sukcesoia/lightSource/eagle/lightSource.pdf

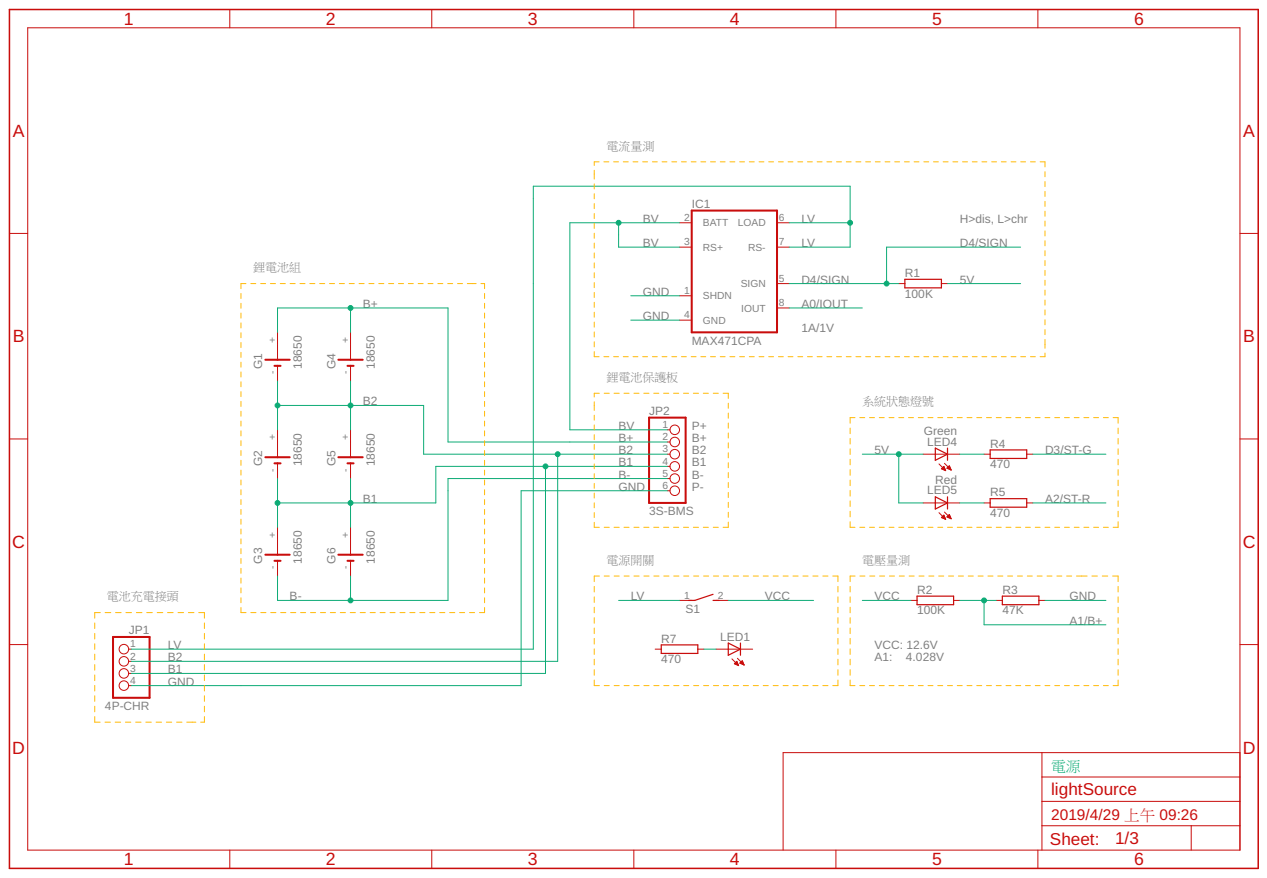
[picture p1: page 1]

18650 18650 18650 4P-CHR 3S-BMSMAX471CPA 100K100K 47K 470 18650 18650 18650 Green Red 470 470 P+B+B2B1B- P- VCC: 12.6V A1: 4.028V 電壓量測 鋰電池保護板 H>dis, L>chr 1A/1V 電流量測 鋰電池組 電源開關 電池充電接頭 系統狀態燈號 G1 + - G2 + - G3 + - JP1 1234 JP2123456 IC1BATT 2 RS+ 3 SHDN 1 GND 4 LOAD 6 SIGN 5 RS- 7 IOUT 8 S1 1 2 R1R2 R3 R7 LED1 G4 + - G5 + - G6 + - LED4 LED5 R4 R5 B2 B2 B2 B1 B1 B1 B- B- B+ B+ LV LVLV LV GND GND GND GND GND BV BVBV VCC VCC D4/SIGN D4/SIGN A0/IOUT 5V 5V A1/B+ A2/ST-R D3/ST-G lightSource 2019/4/29 上午 09:26 Sheet: 1/3 ABCD 1 2 3 4 5 6 ABCD 1 2 3 4 5 6 電源

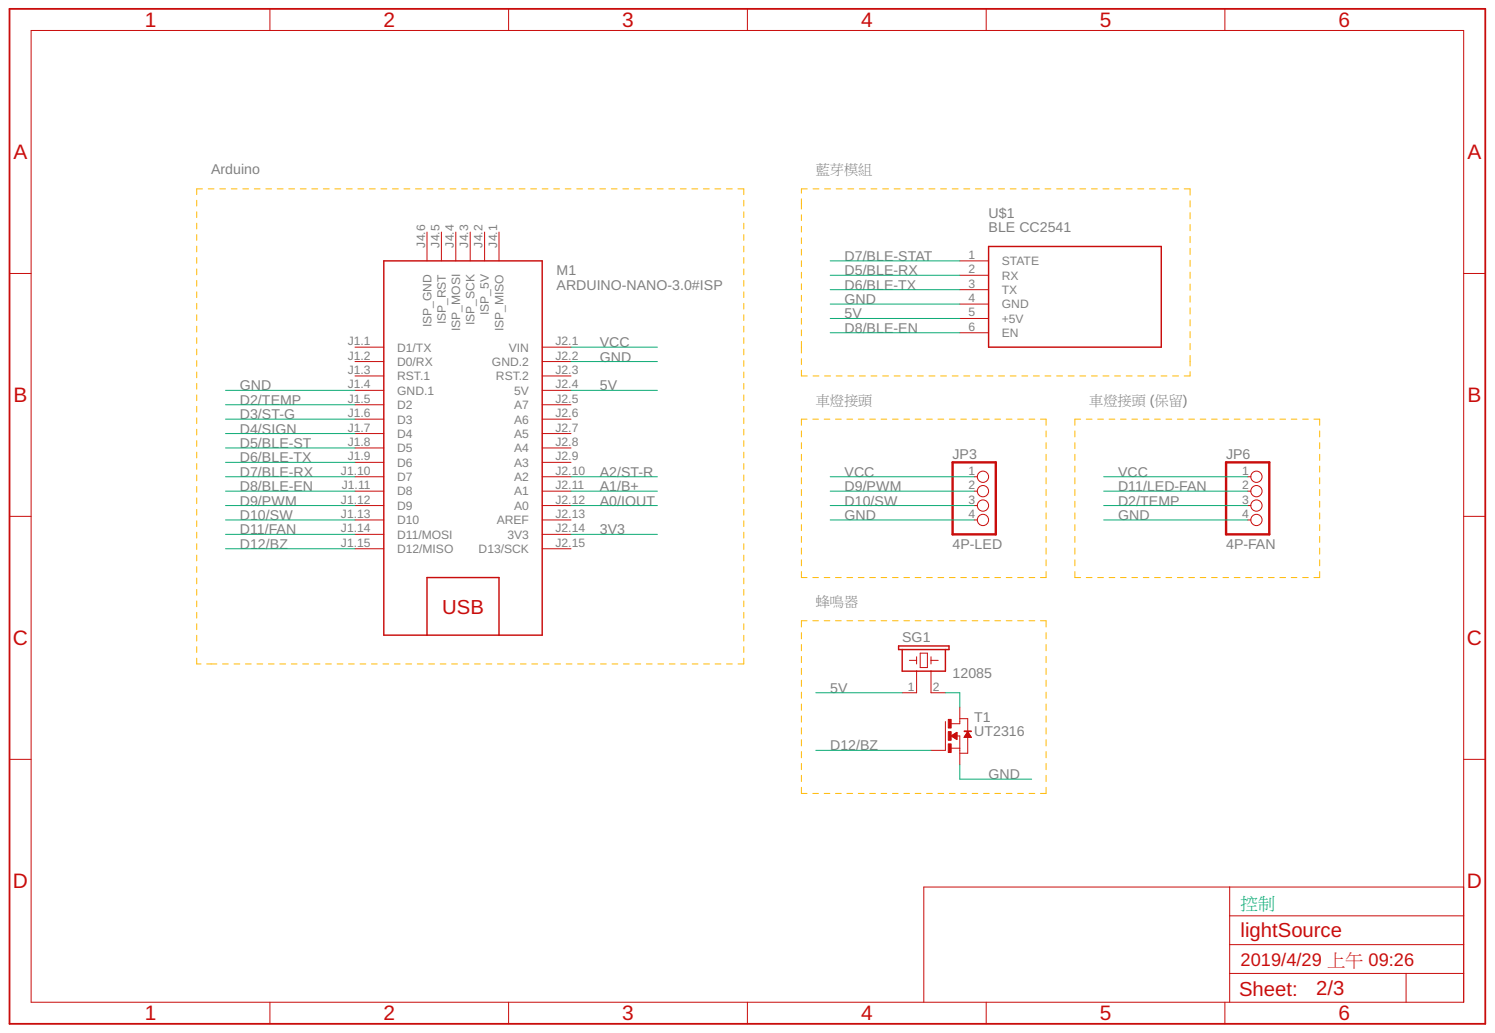
[picture p2: page 2]

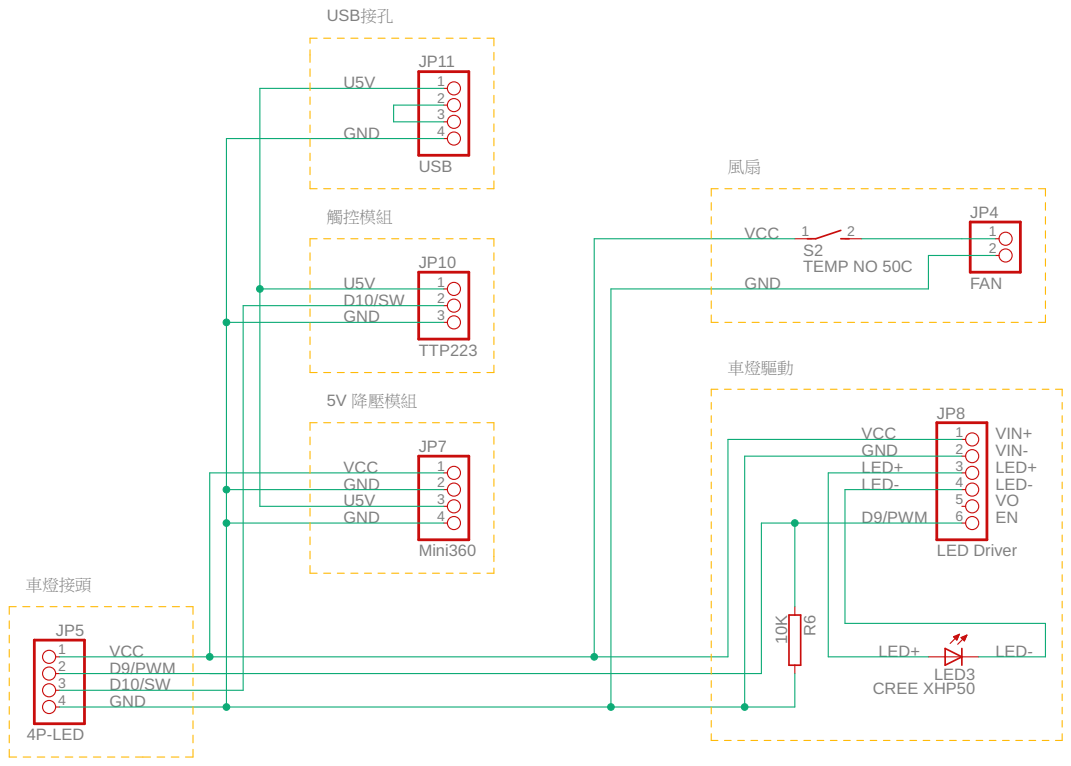
[picture p3: page 3]
