sukcesoia/lightSource/eagle/lightSource.sch

## EAGLE design eagle/lightSource.sch (2019-04-29)

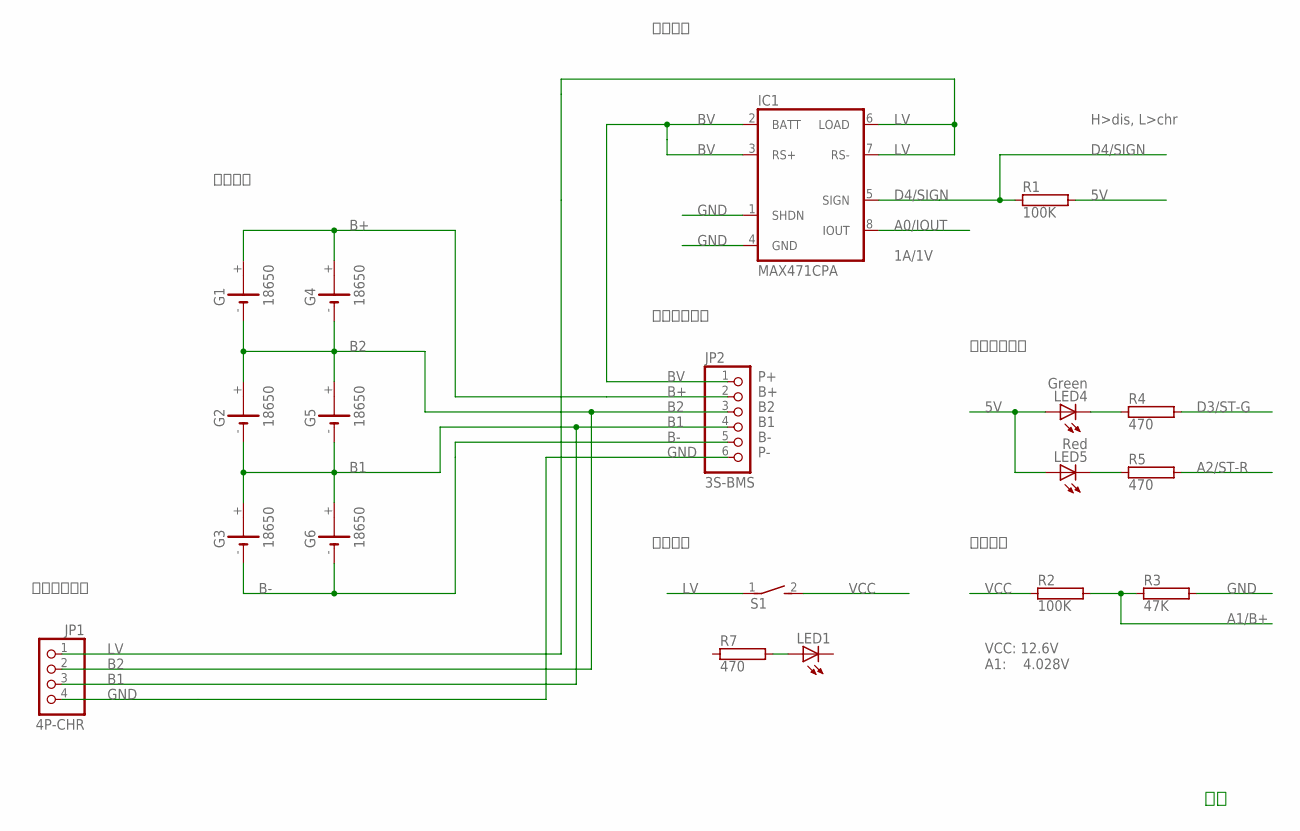
[picture p4: schematic lightSource.sch, sheet 1]

Parts:
G1, G2, G3, G4, G5, G6: 18650; CRAA
IC1: MAX471CPA; DIL08
JP1: 4P-CHR; 1X04
JP2: 3S-BMS; 1X06
LED1: LED5MM
LED4: Green; LED5MM
LED5: Red; LED5MM
R1, R2: 100K; RS1/4
R3: 47K; RS1/4
R4, R5, R7: 470; RS1/4
S1: DS01E; DS-01

Connections:
5V: LED4.A, LED5.A, R1.2
A0/IOUT: IC1.8 (IOUT)
A1/B+: R2.2, R3.1
A2/ST-R: R5.2
B1: G2.-, G3.+, G5.-, G6.+, JP1.3, JP2.4
B2: G1.-, G2.+, G4.-, G5.+, JP1.2, JP2.3
B+: G1.+, G4.+, JP2.2
B-: G3.-, G6.-, JP2.5
BV: IC1.2 (BATT), IC1.3 (RS+), JP2.1
D3/ST-G: R4.2
D4/SIGN: IC1.5 (SIGN), R1.1
GND: IC1.1 (SHDN), IC1.4 (GND), JP1.4, JP2.6, R3.2
LV: IC1.6 (LOAD), IC1.7 (RS-), JP1.1, S1.1
unnamed: LED1.A, R7.2
unnamed: LED4.K (C), R4.1
unnamed: LED5.K (C), R5.1
VCC: R2.1, S1.2

Notes on the sheet:
VCC: 12.6V A1: 4.028V
電壓量測
鋰電池保護板
H>dis, L>chr
1A/1V
電流量測
鋰電池組
電源開關
電池充電接頭
系統狀態燈號

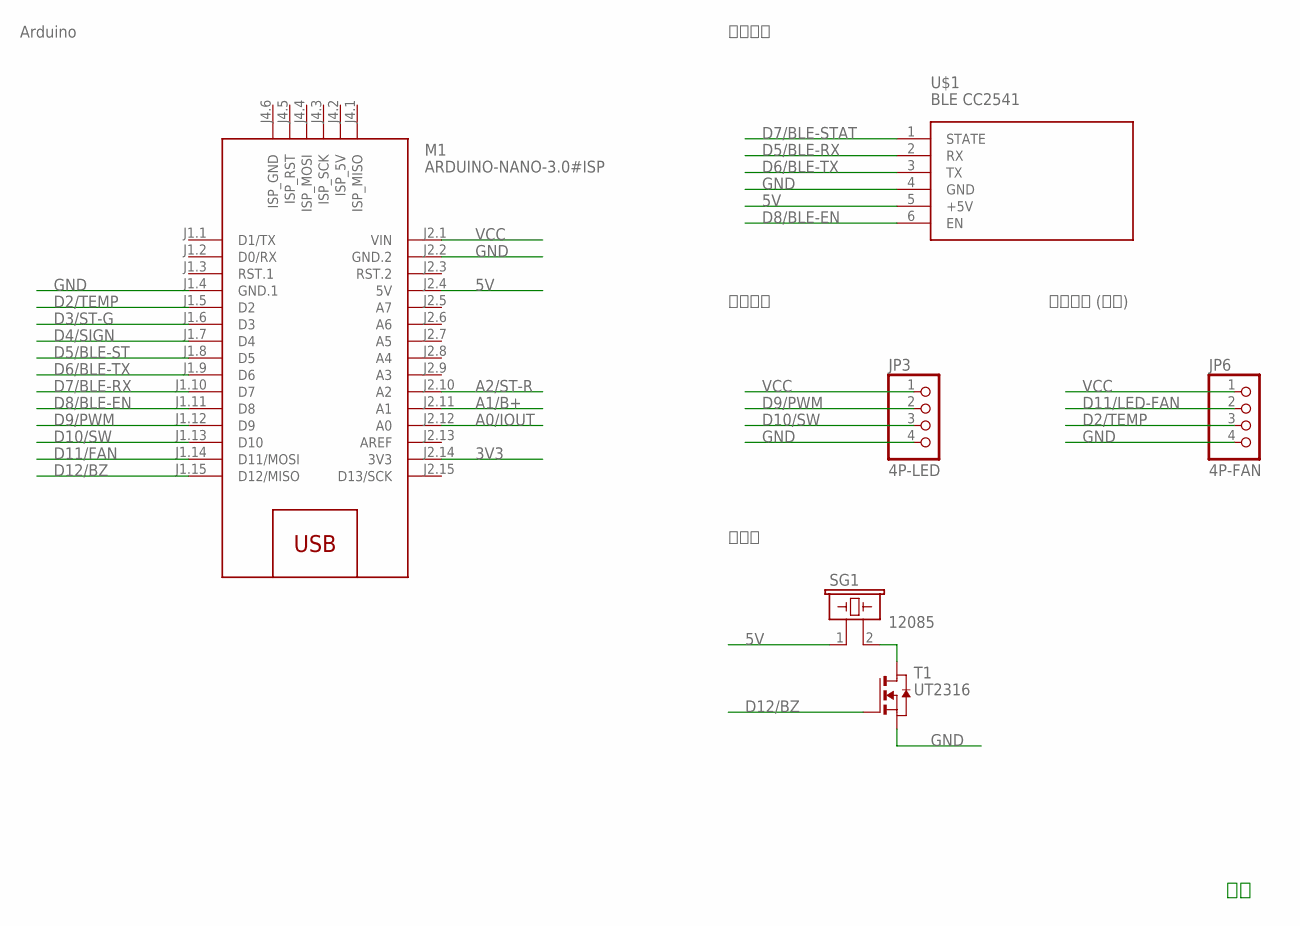
[picture p5: schematic lightSource.sch, sheet 2]

Parts:
JP3: 4P-LED; 1X04
JP6: 4P-FAN; 1X04
M1: ARDUINO-NANO-3.0#ISP
SG1: 12085; B/C11S
T1: UT2316; SOT-23
U$1: BLE CC2541; WIRELESS-BLUETOOTH-HC-05

Connections:
3V3: M1.J2.14 (3V3)
5V: M1.J2.4 (5V), SG1.1, U$1.5 (+5V)
A0/IOUT: M1.J2.12 (A0)
A1/B+: M1.J2.11 (A1)
A2/ST-R: M1.J2.10 (A2)
D2/TEMP: JP6.3, M1.J1.5 (D2)
D3/ST-G: M1.J1.6 (D3)
D4/SIGN: M1.J1.7 (D4)
D5/BLE-RX: U$1.2 (RX)
D5/BLE-ST: M1.J1.8 (D5)
D6/BLE-TX: M1.J1.9 (D6), U$1.3 (TX)
D7/BLE-RX: M1.J1.10 (D7)
D7/BLE-STAT: U$1.1 (STATE)
D8/BLE-EN: M1.J1.11 (D8), U$1.6 (EN)
D9/PWM: JP3.2, M1.J1.12 (D9)
D10/SW: JP3.3, M1.J1.13 (D10)
D11/FAN: M1.J1.14 (D11/MOSI)
D11/LED-FAN: JP6.2
D12/BZ: M1.J1.15 (D12/MISO), T1.3 (G)
GND: JP3.4, JP6.4, M1.J1.4 (GND.1), M1.J2.2 (GND.2), T1.2 (S), U$1.4 (GND)
unnamed: SG1.2, T1.1 (D)
VCC: JP3.1, JP6.1, M1.J2.1 (VIN)

Notes on the sheet:
車燈接頭
藍芽模組
Arduino
車燈接頭 (保留)
蜂鳴器

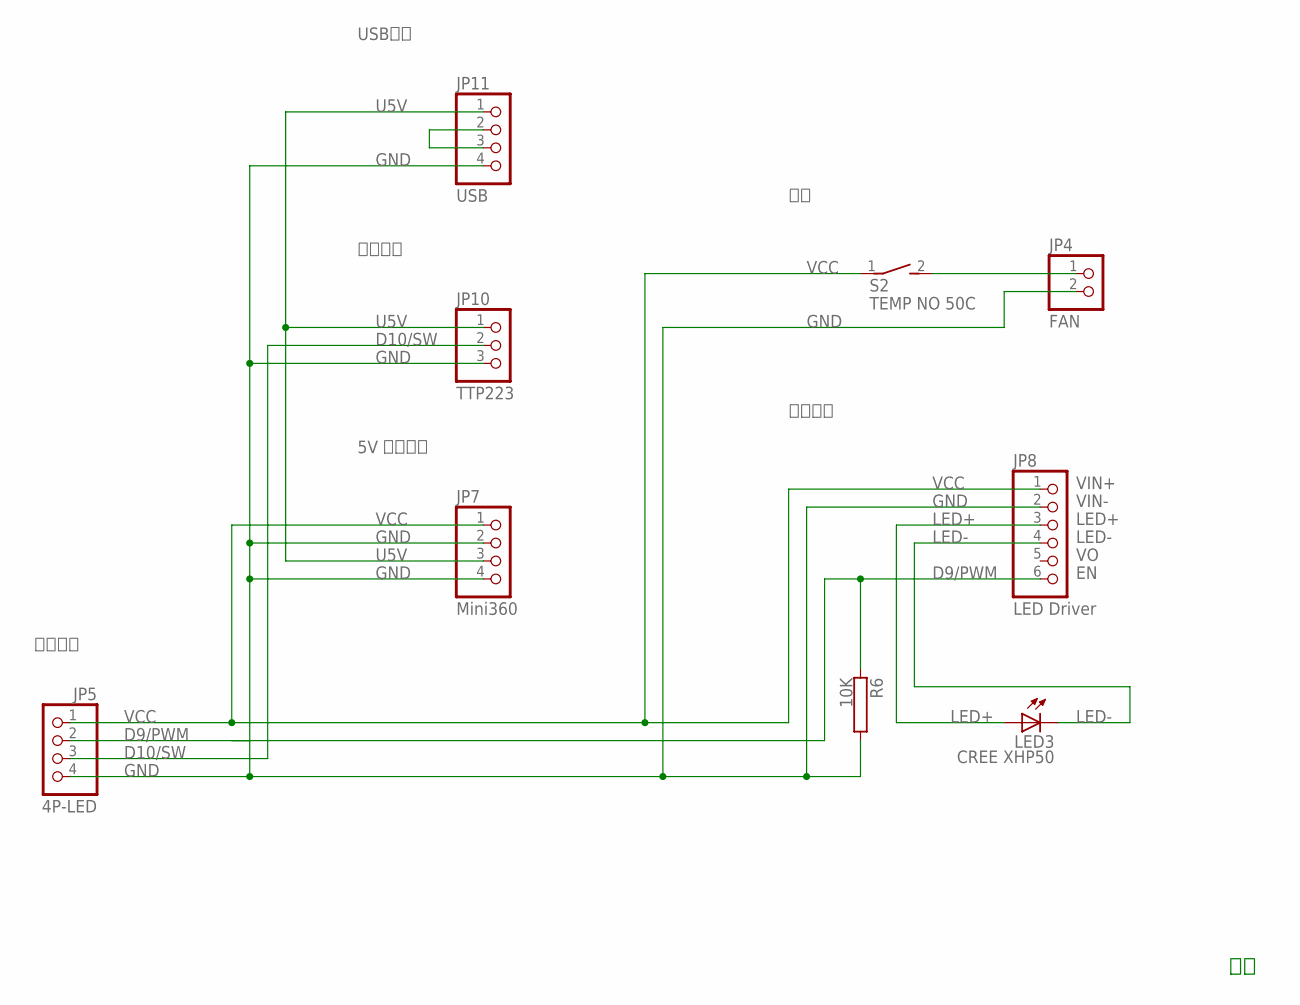
[picture p6: schematic lightSource.sch, sheet 3]

Parts:
JP4: FAN; 1X02
JP5: 4P-LED; 1X04
JP7: Mini360; 1X04
JP8: LED Driver; 1X06
JP10: TTP223; 1X03
JP11: USB; 1X04
LED3: CREE XHP50; LED5MM
R6: 10K; RS1/4
S2: TEMP NO 50C; DS-01

Connections:
D9/PWM: JP5.2, JP8.6, R6.1
D10/SW: JP5.3, JP10.2
GND: JP4.2, JP5.4, JP7.2, JP7.4, JP8.2, JP10.3, JP11.4, R6.2
LED+: JP8.3, LED3.A
LED-: JP8.4, LED3.K (C)
unnamed: JP11.2, JP11.3
unnamed: JP4.1, S2.2
U5V: JP7.3, JP10.1, JP11.1
VCC: JP5.1, JP7.1, JP8.1, S2.1

Notes on the sheet:
VIN+
車燈接頭
車燈驅動
VIN-
LED+
LED-
5V 降壓模組
觸控模組
USB接孔
