sukcesoia/lightSource/(commit log)

2019-04-28 新增 arduino 專案
2019-04-29 新增 android 專案
2019-04-29 新增電路圖
    [lightSource.sch]
